kmwook03/CAN-Failsafe-Node/Reports/M3/CAN-Queue-Integration.md

# M3-2 CAN RX 큐 이관 기록

작업일: 2026-11-09 (Asia/Seoul)

차량 F446RE의 CAN 수신 처리를 ISR → CMSIS 메시지 큐 → `canRxTask`로 이관했다. Node 1은 기존 M2 Normal 펌웨어를 사용한다. **M3-2 정상 통신·RTOS 통합 시험은 사용자 보고 기준 PASS다.** 양 노드 3,000프레임 왕복과 CAN 시험 후 RTOS 진단을 확인했다.

## 사용자 보드 시험 결과

2026-11-09에 전달받은 [차량·조종기 원문 로그](evidence/can-queue/user-reported-uart.txt)를 보존했다.

| 항목 | 결과 | 판정 |
|---|---|---|
| 차량 정상 수신 / 송신 등록 / 송신 완료 | 각각 3,000회 | PASS |
| ISR 수신 / 큐 삽입 / 태스크 처리 | 각각 3,000회 | PASS |
| 큐 손실 / 읽기 오류 / 큐 API 오류 | 모두 0 | 정상 |
| CAN·데이터 오류 / Bus-Off / 타임아웃 / 시작·종료 오류 | 모두 0 | 정상 |
| 큐 최대 점유량 | 1 / 16 슬롯 | 해당 시험에서 적체 관측 없음 |
| ISR 수신부터 태스크 처리까지 관측 최대 대기 | 1ms (HAL tick 기준) | 기록값, 정밀 측정 및 상한 보장 아님 |
| CAN 태스크 최소 스택 여유 | 752 / 1,024 B = 73.4375% | 30% 기준 충족 |
| 조종기 최종 송신 / 에코 검증 | 각각 3,000회, 모든 오류 0 | PASS |
| LED 태스크 최소 스택 여유 | 832 / 1,024 B = 81.25% | 30% 기준 충족 |
| Monitor 태스크 최소 스택 여유 | 808 / 2,048 B = 39.453125% | 30% 기준 충족 |
| RTOS 최소 힙 여유 | 10,184 B | 여유 있음 |
| 시간 기준 / RTOS 오류 | `dt=1000/1000`, `tickErr=0 late=0/0 uartErr=0` | 정상 |
| 진단 / LED 전환 횟수 | `n=66 led=133` | 1초 진단과 0.5초 전환 주기에 부합 |

이번 Node 1 PASS는 RTOS 차량과의 시험에서 얻은 결과다. 2026-11-07의 양 노드 베어메탈 M2 시험 로그로 소급하지 않는다. CAN 처리와 결과 출력 후 다음 RTOS 진단을 추가로 받아 세 태스크의 스택 여유와 오류 카운터를 확인했다.

```text
[M3] n=66 led=133 dt=1000/1000 stackB=832/808 heapMinB=10184 tickErr=0 late=0/0 uartErr=0 canStackB=752
```

Monitor의 최소 스택 여유는 M3-1의 1,192 B에서 808 B로 줄었지만 30% 기준을 충족한다. 이후 기능을 추가할 때 다시 측정한다. 정상 CAN 왕복, 큐 무손실, RTOS 오류 0, 세 태스크 스택 여유 기준을 모두 충족하여 M3-2를 통과로 판정한다.

## 구현

- RX ISR은 한 번에 최대 3프레임을 꺼내 도착 시각과 함께 16슬롯 큐로 복사한다. `osMessageQueuePut()`의 timeout은 0이며, 실패 횟수를 별도 기록한다.
- AboveNormal 우선순위의 CAN 태스크가 검증·에코 송신·타임아웃·종료 판정을 담당한다. 큐 대기는 최대 10tick이며 프레임 도착 시 즉시 대기에서 풀린다.
- 큐는 커널 초기화 후 생성하고 CAN은 태스크에서 시작한다. 인터럽트가 아직 없는 큐를 사용하는 순서 문제를 피한다.
- M2와 동일한 ID/DLC/순번/페이로드를 사용한다. 길이가 정상인 손상 페이로드도 원문 그대로 에코한다.
- 수신/큐 삽입/처리/정상 검증/송신 등록/송신 완료가 모두 3,000회이고 오류와 잔여 큐 항목이 없어야 CAN PASS다.
- 첫 수신 전에는 계속 기다린다. 첫 수신 후 무수신 1초 이상, 전체 65초 이상, 큐 내 체류 1초 이상이면 실패로 종료한다. 마지막 수신 뒤 100ms를 기다려 송신 완료를 확인한다.
- 종료 시 CAN 알림과 세 IRQ를 끄고 결과를 고정한다. CAN 태스크는 suspend 상태로 남겨 스택을 확인하며 LED/진단 태스크는 계속 실행된다.
- UART 출력은 monitorTask만 수행한다. CAN 큐 최대 점유량, 최대 대기 시간, CAN 태스크 스택 여유를 추가했다.

## 보존과 검증

- M3-1 소스와 기록은 변경 전에 `C:\Users\kmwook\Desktop\docs\M3-1-baseline-2026-11-09.zip`으로 보존했다. SHA-256: `6f09b460fa049e3c2c164943e8a54a67dc45256004e4fd1bd273f0e82f6bba1d`.
- M3-1의 10분 PASS 기록과 이전 빌드 증빙은 그대로 유지했다. M3-2 증빙은 `evidence/can-queue/`에 분리한다.
- CubeMX로 재생성하여 새 태스크/우선순위/스택과 큐 생성·진입점 USER CODE 보존을 확인했다.
- Debug/Release 모두 오류 0건·경고 0건으로 빌드했다. 최종 ELF의 SVC/PendSV/SysTick/TIM6 및 CAN TX/RX0/SCE 벡터 연결, 실제 CAN 콜백과 큐 함수의 링크를 확인했다. 결과와 바이너리 해시는 `evidence/can-queue/build-summary.json`에, 컴파일 로그와 소스 해시는 같은 폴더에 기록했다.
- 실물 CAN 정상 통신, CAN 처리 후 세 태스크의 최소 스택 여유와 RTOS 오류 값은 사용자 전달 로그로 확인했다. 에이전트가 보드를 직접 조작하거나 UART를 수집한 결과는 아니다. queue overflow/Bus-Off 오류 주입은 미검증이다.

| 구성 | text | data | bss | 결과 |
|---|---:|---:|---:|---|
| Debug | 38,872 B | 104 B | 21,208 B | 오류 0 / 경고 0 |
| Release | 22,832 B | 104 B | 21,200 B | 오류 0 / 경고 0 |

ELF 크기와 컴파일러의 함수별 스택 보고서는 실행 중 최대 스택 사용량을 보장하지 않는다. 위 스택 판정은 CAN 결과 출력 이후 사용자가 전달한 실제 `stackB`/`canStackB` 값을 근거로 한다.

## 후속 작업

다음 단계는 Node 1을 RTOS로 이관해 20ms 주기 송신과 수신 큐를 구성하고 양 노드 RTOS 상태에서 왕복 시험을 반복하는 것이다. 실행 순서와 M3-2 합격 기준은 [M3_CAN_TEST.md](../../Firmware/Node2_Vehicle_F446RE/M3_CAN_TEST.md)에 있다. 나머지 주변장치 태스크 통합, 오류 주입, 전체 M3 24시간 시험은 별도로 남아 있다.
