kmwook03/CAN-Failsafe-Node/Reports/M3/Controller-RTOS-Migration.md

# M3-3 조종기 RTOS 이관 기록

작업일: 2026-11-09 (Asia/Seoul)

Node 1 L432KC의 20ms CAN 송신과 에코 검증을 FreeRTOS로 이관했다. 차량 Node 2는 M3-2에서 검증한 구성을 사용한다. **M3-3 정상 통신·RTOS 통합 시험은 사용자 보고 기준 PASS다.** 이번에 전달받은 양 노드 로그로 3,000회 왕복과 CAN 결과 출력 이후의 스택 여유·RTOS 상태를 확인했다.

## 사용자 보드 시험 결과

2026-11-09에 전달받은 [UART 원문 로그](evidence/controller-rtos/user-reported-uart.txt)를 보존했다. 에이전트가 직접 보드를 조작하거나 UART를 수집한 결과는 아니며, 보드에 기록된 바이너리 해시는 독립적으로 읽어 확인하지 않았다.

| 항목 | 조종기 Node 1 | 차량 Node 2 | 판정 |
|---|---|---|---|
| 송신 등록 / 실제 완료 / 정상 수신 | 각각 3,000 | 각각 3,000 | PASS |
| ISR 수신 / 큐 삽입 / 태스크 처리 | 각각 3,000 | 각각 3,000 | PASS |
| 큐 손실 / 읽기 오류 / 큐 API 오류 | 모두 0 | 모두 0 | 정상 |
| 데이터·CAN 오류 / Bus-Off / 타임아웃 / 시작·종료 오류 | 모두 0 | 모두 0 | 정상 |
| 큐 최대 점유량 | 1 / 16 | 1 / 16 | 해당 시험에서 적체 관측 없음 |
| 큐 최대 대기 시간 | 0ms | 1ms | HAL tick 기준 관측값 |
| 송신 설정 주기 / 최대 지각 / 슬롯 누락 / 대기 API 오류 | 20ms / 0tick / 0 / 0 | 해당 없음 | 정상 |
| RTOS / HAL 시간 증가량 | 1000 / 1000 | 1000 / 1000 | 정상 |
| tickErr / late / uartErr | 0 / 0·0 / 0 | 0 / 0·0 / 0 | 정상 |
| 최소 힙 여유 | 9,048 B | 10,184 B | 여유 있음 |
| 진단 / LED 전환 횟수 | n=64 / led=129 | n=65 / led=131 | 1초 진단·0.5초 LED 전환 주기에 부합 |

| 보드 / 태스크 | 최소 스택 여유 | 할당량 | 여유 비율 |
|---|---:|---:|---:|
| 조종기 LED | 832 B | 1,024 B | 81.25% |
| 조종기 Monitor | 784 B | 2,048 B | 38.28% |
| 조종기 CAN TX | 808 B | 1,024 B | 78.91% |
| 조종기 CAN RX | 800 B | 1,024 B | 78.13% |
| 차량 LED | 832 B | 1,024 B | 81.25% |
| 차량 Monitor | 808 B | 2,048 B | 39.45% |
| 차량 CAN RX | 752 B | 1,024 B | 73.44% |

모든 태스크가 최소 스택 여유 30% 기준을 충족한다. 조종기 Monitor의 여유가 가장 작으므로 이후 기능 통합 시 다시 측정한다. `maxWaitMs=0`은 동일 HAL tick 안에 처리됐다는 뜻이며 지연 시간이 물리적으로 0이라는 뜻은 아니다. `maxLateTicks=0`도 1ms 해상도에서 관측한 태스크 실행 지각 값으로, CAN 버스 전송 간격의 정밀 측정이나 최악 지연 상한 보장은 아니다.

이번 결과는 약 1분간 3,000회 CAN 왕복과 시험 종료 후 RTOS 상태를 확인한 것이다. 조이스틱·버튼·LCD 통합, 오류 주입, 전체 M3 24시간 시험은 별도로 남아 있다.

## 구현 범위

| 태스크 | CMSIS 우선순위 | 스택 | 역할 |
|---|---:|---:|---|
| canTxTask | AboveNormal1 (33) | 1,024 B | CAN 시작/송신/정지, 20ms 주기, 종료 판정 |
| canRxTask | AboveNormal (32) | 1,024 B | ISR 큐에서 에코 수신, 순번·페이로드 검증 |
| ledTask | Normal (24) | 1,024 B | 녹색 LED 500ms 토글 |
| monitorTask | Low (8) | 2,048 B | UART 단일 출력, 시간·스택·힙·오류 진단 |

- STM32CubeL4 V1.18.2에 포함된 FreeRTOS V10.3.1 / CMSIS-RTOS2 / ARM_CM4F / heap_4를 사용한다. 힙은 15,360 B, RTOS SysTick은 1kHz다.
- HAL 1ms 시간 기준은 TIM6로 분리했다. PCLK1과 타이머 클록은 48MHz, PSC=47, ARR=999다. M2에서 사용한 LSE 기준 MSI 자동 보정을 스케줄러 시작 전 적용한다.
- CAN은 Normal 500kbps, Prescaler=6, BS1=13, BS2=2, SJW=2다. CubeMX의 `CAN1.NART=ENABLE`로 자동 재전송 설정을 보존한다.
- CAN TX/RX0/SCE IRQ 우선순위는 5, SysTick/PendSV와 TIM6는 15다. 커널 호출 가능 IRQ 경계도 5다.
- 커널 초기화 후 16슬롯 수신 큐를 생성하고 모든 태스크 생성 성공을 확인한다. CAN은 TX 태스크에서 시작한다. RX 태스크는 준비 플래그를 기다린 뒤 큐에서 대기한다.
- RX ISR은 한 번에 최대 3프레임을 읽고 헤더·도착 시각·8바이트 데이터를 큐에 복사한다. ISR 큐 삽입 timeout은 0이다. ISR 안에서 UART나 프로토콜 검증을 수행하지 않는다.
- 조종기는 ID `0x100`으로 순번 0…2999와 `55 AA 12 34` 꼬리를 보내고, ID `0x200`의 동일 데이터를 검증한다. 전송 등록과 실제 TX mailbox 완료를 별도 집계한다.
- 시작 후 2초 대기, 20tick 절대 주기, 마지막 송신 뒤 1초 대기다. 20tick 이상 늦으면 `slips`를 누적하고 다음 기준 시각을 재설정해 밀린 송신을 연속 실행하지 않는다. uint32 tick 래핑을 고려하며 실행 제한은 첫 송신 예정 시각부터 65초다.
- Bus-Off, 큐 손실/오류, 읽기 오류, 송신 등록 실패는 조기 종료 조건이다. 오래된 큐 항목은 타임아웃으로 처리한다. 수신 부족과 데이터 오류도 최종 PASS를 막는다.
- 종료할 때 CAN 알림/IRQ를 끄고 CAN을 정지하며 RX 태스크를 suspend한 뒤 결과를 고정한다. TX도 suspend 상태로 남겨 두 태스크의 스택 여유를 계속 읽는다.
- CAN PASS에는 수신/큐 삽입/처리/정상 검증/송신 시도/등록/완료 각각 3,000회, 빈 큐, 오류·주기 누락 0이 모두 필요하다. RTOS 오류와 스택 기준은 CAN PASS와 별도로 확인한다.
- 스택 overflow·malloc 실패·assert는 `m3.fatal_reason`을 남기고 정지한다. UART는 monitorTask만 사용한다.

이번 단계에서는 M1의 조이스틱/버튼/LCD 애플리케이션을 실행하지 않는다. 해당 기능의 태스크 통합은 후속 단계다. 기존 M2 모듈은 `M2_TEST_ENABLED=0`으로 보존하며 동시에 활성화하면 컴파일 오류가 발생한다.

## 보존과 검증

- 수정 전 M3-2 전체 소스/기록을 `C:\Users\kmwook\Desktop\docs\M3-2-baseline-2026-11-09.zip`으로 보존했다.
- ZIP SHA-256: `c1dabe434612ba76a19f57a8c294c1c9deb2ca2155343b7aaef9675372341b5a`.
- M2/M3-1/M3-2 시험 증빙은 유지하고 이번 빌드 증빙은 `evidence/controller-rtos/`에 분리한다.
- Debug/Release 초기 빌드와 CubeMX 재생성 이후 최종 빌드 모두 오류 0건·컴파일 경고 0건으로 완료했다. 최종 빌드와 정적 연결 검사 결과는 같은 폴더의 `build-summary.json`에 기록했다. 빌드/링크 검사는 보드 실행을 대신하지 않는다.
- ELF의 SVC/PendSV/SysTick/TIM6와 CAN TX/RX0/SCE 벡터, 실제 CAN 콜백, 큐·태스크 플래그 함수, overflow/malloc hook의 강한 심볼 연결을 확인했다. M2 시험 함수는 최종 바이너리에 연결되지 않았다.
- CubeMX 재생성 뒤 태스크 진입점·큐 생성·LSE 보정·assert/hook의 USER CODE와 Debug/Release FreeRTOS 빌드 경로를 확인했다. CubeMX 6.18.1은 기존 ADC/DMA·가상 핀 메타데이터 관련 메시지와 IocParser 예외를 출력했으나 생성/저장은 최종 OK로 끝났다. 로그를 보존했고 생성된 코드 및 재빌드를 별도로 검증했다. 저장 파일의 IP 개수는 실제 10개 항목과 일치하도록 정리했다.
- 차량 측 소스·설정·문서 155개는 수정 전 SHA-256과 모두 일치한다. Debug/Release 산출물과 IDE 개인 설정은 이 비교 대상에서 제외했다.
- 실행 중 스택 여유, 송신 태스크 지각 관측치와 양 노드 3,000회 왕복은 위 사용자 로그로 확인했다. 오류 주입과 장시간 시험은 미검증이다. `build-summary.json`의 hardware pending 표기는 보드 로그 수신 전 빌드 당시 상태이며, 기존 빌드 증빙은 그대로 보존한다.

| 구성 | text | data | bss | 결과 |
|---|---:|---:|---:|---|
| Debug | 44,316 B | 100 B | 21,380 B | 오류 0 / 경고 0 |
| Release | 26,632 B | 100 B | 21,372 B | 오류 0 / 경고 0 |

최종 ELF SHA-256:

- Debug: `65d43372e968556f0f90988506767b1cb0f7122f1d9d836a9e0dfb99370fac36`
- Release: `2505990bfbec3ac1787c723a2f2f1b688e113c782ee9c9407e007cb2cf248d71`

실행 순서와 제출할 로그는 [Node 1 M3_TEST.md](../../Firmware/Node1_Controller_L432KC/M3_TEST.md)에 있다. 차량을 먼저 리셋하고 READY를 확인한 다음 조종기를 리셋한다.
