kmwook03/CAN-Failsafe-Node/Reports/M3/evidence/user-reported-uart.txt

M3-1 사용자 전달 기록
기록일: 2026-11-09 (Asia/Seoul)
출처: 사용자가 이 채팅에 전달한 UART 값과 LED 관찰.
UART에서 직접 저장한 원본 파일은 아니다. COM 포트, 빌드 구성,
실제 다운로드한 바이너리 해시는 전달되지 않았다.

[1] 사용자 원문
dt=1000/1000 stackB=832/1192 heapMinB=12048 tickErr=0 late=0/0 uartErr=0, LED는 빨강초록 점멸 중

[2] 최초 표본의 판정 범위 (후속 확인 전)
- 전달 표본에서 RTOS/HAL 증가량은 1000/1000으로 일치한다.
- LED 태스크 스택 여유: 832/1024 bytes = 81.25%.
- 진단 태스크 스택 여유: 1192/2048 bytes = 58.203125%.
- 두 태스크 모두 이 표본에서는 계획의 여유 30% 기준을 충족한다.
- 관측된 RTOS 최소 힙 여유는 12048 bytes.
- tick 불일치, 주기 대기 실패, UART 오류 카운터는 모두 0.
- LED 점멸은 사용자 보고이나 LED의 보드 표기(LD2 등)와 0.5초 전환 간격은 미확인.
- n/led 카운터와 m3.fatal_reason 값은 전달되지 않았다.
- 10분 연속 시험, 리셋/HardFault 이력, 전체 M3 24시간 시험은 미확인.

[3] 10분 실행 후 사용자 원문 (2026-11-09)
10분 실행 결과 Err 값은 전부 0이고 LD2도 0.5초마다 점멸함. [M3] n=668 led=1337 dt=1000/1000 stackB=832/1192 heapMinB=12048 tickErr=0 late=0/0 uartErr=0.

[4] 후속 판정
- 사용자 보고를 근거로 M3-1의 10분 기본 동작 시험 PASS.
- n=668은 1초 진단 주기에서 약 668초(11분 8초)의 실행과 일치한다.
  정밀 시간 실측값은 아니다.
- led=1337은 시작 직후 1회 전환 + 668초 동안 초당 2회 전환과 일치한다.
- LD2의 0.5초 전환 간격을 사용자가 확인했다.
- tickErr=0, late=0/0, uartErr=0이며 스택·최소 힙 여유가 최초 표본과 같다.
- 에이전트가 보드를 직접 측정한 기록은 아니며 원본 연속 UART 파일은 없다.
- 전체 M3(양 노드 태스크 이관 및 24시간 시험)의 완료 판정은 아니다.
