kmwook03/CAN-Failsafe-Node/Docs/Plan.md

# 계획서

## 0. 개요

조이스틱 입력을 CAN 메시지로 변환해 전송하는 조종기 노드와, 이를 수신해 모터를 구동하되 자체 판단으로 명령을 거부할 수 있는 차량 노드로 구성된 2노드 분산 제어 시스템을 설계한다.  두 개의 노드로 분리하고 CAN을 도입한 이유는, 실제 차량 E/E 아키텍처의 최소 단위를 재현하기 위해서이다. 오늘날 차량에서 스티어링 조작은 배선으로 바퀴에 전달되지 않는다. 메시지로 변환되어 네트워크를 타고 흐르고, 수신측 ECU가 이를 해석해 액추에이터를 움직인다. 이 구조에서는 "명령이 도착하지 않았을 때 어떻게 행동할 것인가"가 기능 구현만큼 중요해진다.이 프로젝트의 목표는 동작하는 RC카를 만드는 것이 아니라, 그 질문에 대한 답을 설계로 구현하고 수치로 증명하는 것이다.

### 사용 보드

| 역할 | 보드 |
| --- | --- |
| Node 1: 조종기 | STM32 NUCLEO-L432KC |
| Node 2: 차량 | STM32 NUCLEO-F446RE |

## 1. 시스템 아키텍처

```
┌───────────────────────────────────┐        ┌───────────────────────────────────┐
│  Node 1 : REMOTE (CAN ID 0x100)   │        │  Node 2 : VEHICLE (CAN ID 0x200)  │
│  ── NUCLEO-L432KC (Cortex-M4F) ── │        │  ── NUCLEO-F446RE (Cortex-M4F) ── │
│                                   │        │                                   │
│  CLK : MSI 48MHz (LSE 트리밍)      │  CAN   │  CLK : HSE 8MHz Bypass → 160MHz   │
│  Joystick  ─ ADC1 + DMA           │◄──────►│  HC-SR04 ─ TIM Input Capture      │
│  Buttons×3 ─ EXTI                 │500kbps │  L298N   ─ TIM3 PWM 20kHz         │
│   LCD      ─ I2C1 + DMA           │ 120Ω×2 │  Motor L / R (Differential Drive) │
│  전원 : USB 보조배터리 (배터리 구동) │        │  전원 : 18650 ×2 + 보조배터리      │
└───────────────────────────────────┘        └───────────────────────────────────┘
```

이 시스템의 출발점은 조종기와 차량을 두 개의 독립 컴퓨터로 만든다는 결정이다. 각 MCU는 서로 다른 일을 하며 CAN 버스를 통해 메시지로 통신한다. 노드 1은 사람의 의도를 읽어 메시지로 만들고 노드 2는 메시지를 물리적인 힘으로 구현한다.

Node 1은 계산량이 거의 없기 때문에 NUCLEO-L432KC 보드를 사용하기로 하였고, Node 2는 초음파 센서 반사파 도달 시간 실시간 측정, 두 모터의 PWM을 20kHz로 제어, 동시에 CAN 수신과 안전 상태 판정 체크 등 실시간 부담이 크기 때문에 NUCLEO-F446RE 보드를 사용하기로 하였다.

CAN에는 별도의 클럭 선이 없기 때문에 송신측과 수신측이 각자의 클럭으로 비트 경계를 판단하고 데이터 자체의 엣지를 보며 조금씩 서로 보정해야 한다.

### 1-1. **태스크 설계 - Node 1 (조종기 / L432KC @ 48 MHz)**

| 태스크 | 우선순위 | 주기 | 스택(word) | 역할 | 블로킹 |
| --- | --- | --- | --- | --- | --- |
| `CanTxTask` | 4 | 20ms | 256 | 제어 프레임 송신, Counter/CRC 부착 | osDelayUntil |
| `InputTask` | 3 | 10ms | 256 | ADC 이동평균, 데드존, 버튼 디바운스 | osDelayUntil |
| `CanRxTask` | 3 | 이벤트 | 256 | 차량 텔레메트리 수신 → 상태 저장 | Queue Wait |
| `UiTask` | 1 | 100ms | 512 | 1602 I2C LCD 프레임버퍼 렌더 + I2C DMA 전송 | DMA Semaphore |

### 1-2. **태스크 설계 - Node 2 (차량 / F446RE @ 160 MHz)**

| 태스크 | 우선순위 | 주기 | 스택(word) | 역할 | 블로킹 |
| --- | --- | --- | --- | --- | --- |
| `SafetyTask` | 5 | 20ms | 256 | 센서/링크 상태 종합 → 시스템 상태 결정 | osDelayUntil |
| `SensorTask` | 4 | 50ms | 256 | HC-SR04 트리거 
+ Input Capture 결과 수신 | Semaphore
(타임아웃 30ms) |
| `CanRxTask` | 4 | 이벤트 | 256 | 명령 파싱, CRC 검증, 최종 수신시각 갱신 | Queue Wait |
| `MotorTask` | 3 | 20ms | 256 | PWM 유일 소유자.
상태에 따라 출력 결정 + IWDG 갱신 | osDelayUntil |
| `TelementryTask` | 1 | 100ms | 256 | 차량 상태를 조종기로 회신 | osDelayUntil |

RMS(Rate Monotonic)를 기본으로 하되, 안전 관련 태스크는 주기와 무관하게 상위 배치 하였다.

총 CPU 이용률 U = ∑(Ci/Ti)를 실측하여 Liu & Layland 한계(n = 5 → 약 74%) 이내임을 증명할 것이다.

## 2. **Fail-safe 설계**

### 2-1. **단일 소유권(Single Ownership) + 상태 머신**

```
[SensorTask]  ─┐
[CanRxTask]   ─┼─► (Shared State + Mutex) ─► [SafetyTask] ─► g_system_state
[Button/EXTI] ─┘                                                    │
                                                                    ▼
                                                  [MotorTask] ──► PWM (유일한 쓰기 주체)
```

다른 태스크들은 모터를 건드리는 대신, SafetyTask에 데이터를 전송한다. 즉, 판단은 하지 않고 관측만 하는 것이다. 판단은 SafetyTask에서 받은 데이터들을 취합하여 시스템이 어떤 상태여야하는지 결정한다. MotorTask는 20ms마다 깨어나 상태를 읽고, 그 상태에 적합한 출력을 PWM에 쓴다. 이를 통해 SensorTask와 MotorTask의 경쟁 상태가 발생할 수 없도록 한다.

시스템의 상태는 아래와 같이 설계하였다.

| 상태 | 진입 조건 | 모터 출력 | 탈출 조건 |
| --- | --- | --- | --- |
| `INIT` | 부팅 | 정지 | 자가진단 통과 |
| `SAFE_STOP` | 시동 전 / 리셋 후 | 정지 | 조이스틱 중립 버튼
 + Arm 버튼 |
| `RUN` | 정상 | CAN 명령대로 | 아래 조건 발생 시 전이 |
| `EMERGENCY_BRAKE` | 전방 < 15cm AND 전진 명령 | 강제 정지 (후진 허용) | 거리 > 25cm 
(히스테리시스) |
| `LINK_LOST` | 마지막 유효 CAN 수신 후 > 150ms | 정지 | 유효 프레임 3연속 수신 |
| `FAULT` | 센서 무응답 / Bus-Off /
CRC 연속 오류 | 정지 (Latched) | 수동 리셋 |

충돌 위험 감지 거리와 해제 거리가 서로 다른 이유는, 같은 거리(15cm)로 평가를 하게 되면 차량이 15cm 경계에 있을 때 센서 노이즈가 14.9와 15.1 사이로 튀며 모터가 돌았다 멈췄다를 반복하기 때문이다.

### 2-2. **Link Loss Detection**

이 시스템은 네트워크를 사용해 통신한다. 네트워크가 가져오는 위험은 다음과 같다.

1. 메시지가 안옴
    
    조종기가 죽었거나 케이블이 빠진 경우다. 이 때 차량이 이전 명령을 유지하면 마지막 명령이 전진이었을 경우 차는 계속 달린다. 따라서 150ms 타임아웃을 설정하여 정지시킬 것이다.
    
2. 메시지가 오는데 내용이 안바뀜
    
    송신 태스크가 행에 걸렸는데 하드웨어 버퍼가 같은 프레임을 계속 재전송하는 경우다. 이 때는 타임아웃이 아닌 롤링 카운터로 판별해야 한다.
    
3. 메시지가 깨짐
    
    모터 노이즈나 비트 오류로 데이터가 변형된 경우다. 스로틀 0이 100으로 바뀌면 치명적일 수 있다. CRC-8로 검증하고 틀리다면 그 프레임을 버리는 방식으로 방어할 것이다.
    
4. 물리계층이 망가짐
    
    CAN 컨트롤러는 오류가 누적되면 스스로 버스에서 이탈한다(Bus-Off). 이를 감지해 카운터에 기록해두고 재초기화를 시도하는 로직을 추가한다. 핵심은 침묵이 아닌 기록 남기기다.
    
5. 소프트웨어가 멈춤
    
    태스크가 데드락에 빠지면 모든 로직이 무력화된다. 이를 방지하기 위해 독립 워치독이 100ms마다 갱신을 요구하고 갱신되지 않으면 MCU를 강제로 리셋한다. 갱신 책임은 MotorTask가 갖는다. 실제로 액추에이터를 제어하는 태스크가 살아있는지 확인하고싶은 것이기 때문이다.

리셋되면 부팅 후 SAFE_STOP으로 들어간다. 이 때 모터는 정지상태이므로, 결과적으로 모든 실패 경로가 정지로 수렴하도록 설계하였다.

| 기법 | 구현 | 검출 대상 |
| --- | --- | --- |
| **Timeout (E2E)** | 20ms 주기 송신 → 150ms 미수신 시 LINK_LOST | 케이블 단선, 조종기 전원 차단 |
| **Rolling Counter** | 0~15 순환, 값이 정지하면 Freeze 판정 | 송신 태스크 행(Hang), 버퍼 재전송 |
| **CRC-8 (SAE J1850)** | Payload 7바이트 → CRC 1바이트 | 비트 오류, 타 노드 오염 |
| **Bus-Off 복구** | HAL_CAN_ERROR_BOF 감지
 → 카운트 기록 후 재초기화 | 물리 계층 이상 |
| **IWDG** | 100ms 타임아웃, MotorTask에서만 갱신 | 태스크 데드락 |

## 3. **클럭 및 CAN 설계**

### 3-1. **조종기(L432KC) 클럭**

CAN은 정확한 클럭을 요구한다. 그러나 NUCLEO-L432KC에는 HSE 크리스털이 실장되어 있지 않다. 고려해볼 수 있는 선택지는 아래와 같았다.

| 방안 | 정확도 | 문제점 | 판정 |
| --- | --- | --- | --- |
| **A. HSI16 그대로** | ±1% 이상 | CAN 허용 오차 초과. 처음엔 되는 듯하다가 **간헐적으로 Error Frame 폭주** | ❌ 불가 |
| **B. SB17 납땜 → ST-LINK MCO 8MHz를 HSE로** | 양호 | **USB를 뽑으면 ST-LINK가 꺼져서 클럭이 사라짐.** 조종기를 배터리로 못 씀. SMD 납땜 필요 | ⚠️ 차선 |
| **C. MSI 48MHz + LSE 32.768kHz 자동 트리밍** | **±0.25% 이내** | LSE 사용 시 D7/D8(PC14/PC15) 사용 불가 (어차피 안 씀) | ✅ **채택** |

STM32L4의 MSI는 LSE 크리스털에 의해 하드웨어적으로 자동 보정(MSI PLL Mode)되며, 이때 정확도가 ±0.25% 이내로 들어온다. NUCLEO-L432KC에는 32.768kHz LSE 크리스털이 기본 실장되어 있으므로 추가 부품 없이 가능하다.

### 3-2. **차량(F446RE) 클럭**

F446RE는 Nucleo-64라 ST-LINK MCO 8MHz가 기본 연결되어 있다(HSE Bypass).

- HSE 8 MHz Bypass → PLL → SYSCLK 160 MHz
- APB1 Prescaler = /4 → PCLK1 = 40 MHz (F446 APB1 최대 45MHz 이내)

PCLK1을 40MHz로 맞추면 아래처럼 두 노드의 tq 개수와 샘플포인트가 완전히 동일해진다. 서로 다른 MCU 간 CAN에서 타이밍 불일치는 가장 흔한 실패 원인이므로, 클럭을 조금 낮추더라도 맞추는 쪽이 이득일 것으로 예상했다.

### 3-3. **CAN 비트 타이밍 (500kbps, 양 노드 동일)**

| 항목 | Node 1 (L432KC) | Node 2 (F446RE) |
| --- | --- | --- |
| 클럭 소스 | MSI 48MHz (LSE 트리밍) | HSE 8MHz Bypass → PLL |
| SYSCLK | 48 MHz | 160 MHz |
| **PCLK1 (CAN 클럭)** | **48 MHz** | **40 MHz** |
| **Prescaler** | **6** | **5** |
| tq 클럭 | 8 MHz | 8 MHz |
| SYNC_SEG | 1 tq | 1 tq |
| **BS1 (TSEG1)** | **13 tq** | **13 tq** |
| **BS2 (TSEG2)** | **2 tq** | **2 tq** |
| **총 tq** | **16** | **16** |
| **Bitrate** | **500 kbps**  | **500 kbps**  |
| **Sample Point** | **87.5%** | **87.5%** |
| **SJW** | **2 tq** | **2 tq** |
- 검산
    - 48 MHz ÷ 6 = 8 MHz, 8 MHz ÷ 16 tq = 500 kHz
    - 40 MHz ÷ 5 = 8 MHz, 8 MHz ÷ 16 tq = 500 kHz

CAN 오실레이터 허용오차는 대략 df ≤ SJW / (20 × NBT_tq) 이다. SJW=1이면 1/(20×16) = 0.3125% 로, MSI의 ±0.25%와 여유가 거의 없다. SJW=2로 올리면 0.625%가 되어 안전 마진이 2배가 되므로 SJW를 2로 설정하였다. 

### 3-4. **CAN 메시지 정의**

**`0x100` — REMOTE_CMD (조종기 → 차량, 20 ms 주기)**

| Byte | 필드 | 타입 | 범위 | 설명 |
| --- | --- | --- | --- | --- |
| 0 | `throttle` | int8 | -100 ~ +100 | 전후진 (%) |
| 1 | `steering` | int8 | -100 ~ +100 | 좌우 조향 (%) |
| 2 | `mode` | uint8 | 0~2 | 0=SAFE, 1=NORMAL, 2=SPORT |
| 3 | `flags` | bitfield | - | bit0=E-Stop, bit1=Arm, bit2=Reserved |
| 4~5 | `reserved` | - | - | 확장용 (0 채움) |
| 6 | `counter` | uint8 | 0~15 | Rolling Counter (하위 4bit) |
| 7 | `crc8` | uint8 | - | Byte0~6에 대한 CRC-8 |

**`0x200` — VEHICLE_STATUS (차량 → 조종기, 100 ms 주기)**

| Byte | 필드 | 설명 |
| --- | --- | --- |
| 0 | `state` | 시스템 상태 (RUN / E_BRAKE / LINK_LOST / FAULT) |
| 1 | `distance_cm` | 전방 거리 (255 = 측정 불가) |
| 2 | `pwm_left` | 좌측 모터 실제 듀티 (%) |
| 3 | `pwm_right` | 우측 모터 실제 듀티 (%) |
| 4 | `err_count` | 누적 CRC/타임아웃 오류 수 |
| 5 | `cpu_load` | CPU 사용률 (%) — 실측 증빙용 |
| 6 | `counter` | Rolling Counter |
| 7 | `crc8` | CRC-8 |

CAN은 ID가 낮을수록 우선순위가 높다. 제어 명령(0x100)에 상태보고(0x200)보다 낮은 ID를 할당한 것은 버스 경합 시 제어 프레임이 먼저 나가야 하기 때문이다.

### 3-5. 버스 부하 계산

표준 프레임 8바이트 ≈ 111 bit + 스터핑 여유 ≈ 130 bit

| 메시지 | 주기 | 초당 프레임 | 초당 비트 | 부하 |
| --- | --- | --- | --- | --- |
| 0x100 | 20 ms | 50 | 6,500 | 1.3 % |
| 0x200 | 100 ms | 10 | 1,300 | 0.26 % |
| 합계 |  |  |  | 약 1.6 % |

---

## 4. 핀 할당

### 4.1 Node 1 — NUCLEO-L432KC (조종기)

> 32핀 패키지라 여유가 적으므로 **아래 표대로 고정**하는 것을 권장합니다.
> 

| 기능 | STM32 핀 | 보드 라벨 | 주변장치 | 비고 |
| --- | --- | --- | --- | --- |
| **CAN1_RX** | **PA11** | **D10** | CAN1 (AF9) | L432KC에서 CAN은 이 조합뿐 |
| **CAN1_TX** | **PA12** | **D2** | CAN1 (AF9) |  |
| Joystick VRx | PA0 | A0 | **ADC1_IN5** | ⚠️ F4의 IN0 아님 |
| Joystick VRy | PA1 | A1 | **ADC1_IN6** | DMA Circular |
| Joystick SW | PA3 | A2 | GPIO Input (Pull-up) |  |
| 1602 I2C LCD SCL | PB6 | D5 | I2C1_SCL | **100 kHz Fast Mode** |
| 1602 I2C LCD SDA | PB7 | D4 | I2C1_SDA | DMA 전송 |
| Button 1 (Arm) | PB0 | D3 | EXTI, Pull-up |  |
| Button 2 (Mode) | PB1 | D6 | EXTI, Pull-up |  |
| Button 3 (E-Stop) | PA8 | D9 | EXTI, Pull-up |  |
| Status LED | PB3 | D13 | 온보드 LD3 (녹색) |  |
| Debug UART TX | PA2 | (A7) | USART2 → VCP | ⚠️ **A7은 다른 용도로 못 씀** |
| Debug UART RX | PA15 | (내부) | USART2 → VCP | 커넥터에 안 나옴 |
| LSE 크리스털 | PC14 / PC15 | **D7 / D8** | OSC32_IN/OUT | 🔒 **GPIO로 사용 불가** |
| SWD | PA13 / PA14 | (내부) | ST-LINK 디버그 | 🔒 사용 불가 |

**남는 자유 핀:** PA4(A3), PA5(A4), PA6(A5), PA7(A6), PA9(D1), PA10(D0), PB4(D12), PB5(D11) → 확장 여유 충분

> ⚠️ **I2C 솔더 브리지 확인:** UM1956에 따르면 A4/A5와 D4/D5의 I2C 배선은 SB16/SB18 설정에 따라 달라진다. 기본 상태에서는 PB6=D5(SCL), PB7=D4(SDA)로 알려져 있으나, LCD가 안 잡히면 이 브리지를 가장 먼저 의심할 것.
> 

### 4.2 Node 2 — NUCLEO-F446RE (차량)

| 기능 | 핀 | 보드 라벨 | 주변장치 | 비고 |
| --- | --- | --- | --- | --- |
| CAN1_RX / TX | PA11 / PA12 | CN10 | CAN1 (AF9) |  |
| Motor L ENA (PWM) | PA6 | D12 | TIM3_CH1 | 20 kHz |
| Motor R ENB (PWM) | PA7 | D11 | TIM3_CH2 | 20 kHz |
| IN1 / IN2 | PB12 / PB13 | CN10 | GPIO Output | 좌측 방향 |
| IN3 / IN4 | PB14 / PB15 | CN10 | GPIO Output | 우측 방향 |
| HC-SR04 TRIG | PC7 | D9 | GPIO Output | 10 µs 펄스 |
| HC-SR04 ECHO | PB6 | D10 | **TIM4_CH1 Input Capture** | ⚠️ 분압 필요 |
| Status LED | PA5 | D13 | 온보드 LD2 |  |
| Debug UART | PA2 / PA3 | - | USART2 → VCP |  |

> **PWM 20 kHz를 쓰는 이유:** 가청 주파수(20Hz~20kHz) 위로 올려 모터 코일 소음("삐----")을 제거하기 위함. L298N은 스위칭이 느려 40kHz 이상은 무리이므로 20kHz가 적정선.
> 

## 5. 부품 명세

### 5-1. 핵심 제어 및 네트워크

| 부품명 | 수량 | 배치 노드 | 용도 및 비고 |
| --- | --- | --- | --- |
| STM32 NUCLEO-F446RE | 1개 | 차량 | 시스템의 메인 두뇌 (Node) |
| STM32 NUCLEO-L432KC | 1개 | 조종기 |  |
| SN65HVD230 CAN 모듈 | 2개 | 조종기(1), 차량(1) | 조종 명령 송신 및 수신 (3.3V 인가) |

### 5-2. 구동부 및 전원

| 부품명 | 수량 | 배치 노드 | 용도 및 비고 |
| --- | --- | --- | --- |
| 2WD 스마트카 섀시 키트 | 1세트 | 차량 | 차량 프레임, 바퀴 2개, DC 기어드 모터 2개 포함 |
| L298N 모터 드라이버 | 1개 | 차량 | NUCLEO의 PWM 신호를 받아 DC 모터에 큰 전력을 공급 |
| 18650 배터리 2구 홀더 & 건전지 | 1세트 | 차량 | **AA 건전지 4구/6구 홀더** 또는 **18650 배터리 2구 홀더** (L298N 메인 전원용) |
| USB 보조배터리 | 2 | 조종기(1), 차량(1) | PC에서 분리하여 사용하기 위함 |
| 0.1 µF 세라믹 커패시터 | 6 | 차량 | 모터 단자에 3개씩 납땜 |

### 5-3. 센서 및 인터페이스

| 부품명 | 수량 | 배치 노드 | 용도 및 비고 |
| --- | --- | --- | --- |
| KY-023 조이스틱 모듈 | 1개 | 조종기 | 전후좌우 조향 아날로그(ADC) 입력 |
| HC-SR04 초음파 센서 | 1개 | 차량 | 차량 전방에 부착, 장애물 거리 측정 
분압(1kΩ + 2kΩ)을 통해 3.3V로 출력을 낮출 것 |
| 1kΩ, 2kΩ 저항 | 각 1개 | 차량 | 초음파 센서 전압 분압용 |
| 1602 I2C LCD | 1개 | 조종기 | 현재 모터 출력, 연결 상태, 경고 메시지 표시 |
| 택트 스위치 (Push Button) | 3개 | 조종기 | 주행 모드 변경 또는 수동 긴급 정지 버튼 |

### 5-4. 배선 및 인프라

| 부품명 | 수량 | 배치 노드 | 용도 및 비고 |
| --- | --- | --- | --- |
| 브레드보드 (830핀 또는 400핀) | 2개 | 조종기(1), 차량(1) | 각 노드별 회로 구성 |
| 점퍼선 세트 (M-M, M-F, F-F) | 1세트 | 조종기(1), 차량(1) | 보드, 모듈, 센서 간 배선 
(암수 혼합 필수, 향후 납땜 예정) |
| Mini-B USB 케이블 | 1개 | 차량 | PC 연결, NUCLEO 펌웨어 다운로드 및 디버깅 |
| Micro-B USB 케이블 | 1개 | 조종기 | PC 연결, NUCLEO 펌웨어 다운로드 및 디버깅 |

### 5-5. 전원 계통도

```
[조종기 Node 1]
  USB 보조배터리 ──(Micro-B)── NUCLEO-L432KC ── 3V3 ─┬── SN65HVD230
                                                    ├── 조이스틱 (KY-023)
                                                    └── 1602 I2C LCD
  ※ MSI+LSE 클럭이므로 ST-LINK 없이도 정상 동작 (HSE였다면 불가)

[차량 Node 2]
  18650 ×2 (7.4V) ──── L298N VMS (모터 구동)
  USB 보조배터리 ──(Mini-B)── NUCLEO-F446RE ── 3V3 ── SN65HVD230
                                           └── 5V ── HC-SR04

★★★ L298N GND ↔ NUCLEO GND ↔ 조종기 GND(CAN 접지) 모두 연결 ★★★
     공통 접지 없으면 모터도 안 돌고 CAN도 안 된다.
```

## 6. 마일스톤 계획 (8주)

각 마일스톤은 완료 기준(DoD)을 만족해야 다음으로 진행.

### 🔹 M0 — 준비 (Week 1)

| 항목 | 내용 |
| --- | --- |
| **목표** | 부품 수령, 개발 환경, 저장소 세팅 |
| **작업** | ① 부품 발주(§5 반영, **케이블 2종 주의**) 
② STM32CubeIDE 설치 
③ **L432KC / F446RE 각각 별도 프로젝트** 생성 
④ Git 저장소 + 회로도 초안 |
| **DoD** | 두 보드 모두 LED 블링크 + `printf`가 UART VCP로 출력. 
**L432KC는 PB3(D13), F446RE는 PA5(D13)** |
| **리스크** | 부품 배송 지연 → 1주차에 즉시 발주 |

### 🔹 M1 — 드라이버 개별 검증 (Week 2)

| 항목 | 내용 |
| --- | --- |
| **목표** | **RTOS 없이 베어메탈로** 각 주변장치 개별 검증 |
| **작업** | **[L432KC]** 
① `HAL_ADCEx_Calibration_Start()` 후 ADC+DMA로 조이스틱 값 UART 출력 
② 1602 I2C LCD 드라이버 이식 
③ 버튼 EXTI + 디바운스 
**[F446RE]** 
④ TIM3 PWM 모터 단독 회전 
⑤ HC-SR04 **Input Capture 방식** 거리 측정 (`HAL_Delay` 폴링 금지) |
| **DoD** | 5개 주변장치가 **각각** 독립 프로젝트에서 동작. 거리 오차 ±2cm 이내 |
| **L432KC 함정** | ADC 캘리브레이션 누락 시 값이 튄다. 채널 번호가 IN5/IN6인 것도 확인할 것. |

### 🔹 M2 — 클럭 & CAN 링크 확립 (Week 3)

> **2026-11-07 검증 상태:** 양 노드 Loopback 정상 확인 및 연결 버스 60Ω 측정 완료(사용자 보고).
> Normal 시험에서 Node 2의 수신·응답 3,000회와 오류 0을 확인했다.
> Node 1 최종 PASS 로그 재확인, CAN 비트폭 2µs 및 MCO 주파수 실측은 남아 있어 M2 전체 완료 판정은 보류한다.
> [검증 결과·실패 이력·남은 항목](../Reports/M2/CAN-Link-Validation.md)

| 항목 | 내용 |
| --- | --- |
| **목표** | 두 노드 간 CAN 프레임 왕복 성공 |
| **작업** | ① [L432KC] LSE 활성화 + MSI 48MHz + MSIPLLEN 설정 후 MCO 핀으로 클럭 출력해 주파수 실측 
② [F446RE] HSE Bypass → 160MHz / APB1 40MHz 
③ 양 노드 **Loopback 모드**로 자체 송수신 검증 
④ CANH-CANL 저항 측정(60Ω 확인) 
⑤ Normal 모드 2노드 통신 
⑥ FIFO0 인터럽트 + Bus-Off 핸들러 |
| **DoD** | 1분간 3,000프레임 송수신 **오류 0건**. 로직 애널라이저로 비트폭 **2 µs (=500kbps)** 확인 |
| **리스크** | 🔴 **여기서 막히면 프로젝트가 멈춘다.** 
체크리스트: 
① LSE 발진 확인(`HAL_RCC_OscConfig` 리턴값) 
② MSIPLLEN 활성 여부 
③ CANH↔CANH / CANL↔CANL 직결(크로스 아님) 
④ 공통 접지 
⑤ 종단 60Ω 
⑥ 트랜시버 3.3V 
⑦ 양 노드 tq=16 일치 |
| **폴백** | 그래도 안 되면 SJW=3 / BS1=12 / BS2=3으로 마진 확대. 
그것도 안 되면 SB17 납땜 후 HSE 방식(방안 B)으로 전환 |

### 🔹 M3 — RTOS 통합 (Week 4)

| 항목 | 내용 |
| --- | --- |
| **목표** | §1의 태스크 구조로 마이그레이션 |
| **작업** | ① CMSIS-RTOS v2 활성화, **HAL Timebase를 TIM6/TIM7로 이관** 
② 태스크 생성 및 우선순위 부여 
③ Queue(CAN RX) / Mutex(공유 상태) / Semaphore(HC-SR04 완료) 
④ `uxTaskGetStackHighWaterMark`로 스택 리사이징 |
| **DoD** | 양 노드 동시 구동 24시간 무정지. 스택 여유 30% 이상. **HardFault 0건** |
| **함정** | RTOS에서 `HAL_Delay()` 금지 → `osDelay()`. ISR에서는 반드시 `...FromISR()` API |

### 🔹 M4 — 주행 통합 (Week 5)

| 항목 | 내용 |
| --- | --- |
| **목표** | 실제로 조종되는 차 |
| **작업** | ① 차동 구동 믹싱 (`L = throttle + steering`, `R = throttle - steering`, 클리핑) 
② 데드존 ±8% 
③ 슬루레이트 제한(급가속 시 전압강하 리셋 방지) 
④ 1602 I2C LCD 대시보드 레이아웃 |
| **DoD** | 조이스틱으로 전진/후진/제자리 회전. 1분 주행 시 리셋 0회 |
| **리스크** | 모터 노이즈 리셋 → 커패시터 추가, 전원 분리 재점검 |

### 🔹 M5 — Fail-safe 구현 (Week 6)

| 항목 | 내용 |
| --- | --- |
| **목표** | §2 상태머신 완성 |
| **작업** | ① 시스템 상태머신 
② 긴급제동(히스테리시스 15/25cm, 후진 허용) 
③ Link Timeout 150ms 
④ Rolling Counter + CRC-8 
⑤ Bus-Off 자동 복구 
⑥ IWDG 100ms 
⑦ 1602 I2C LCD/LED 경고 표시 |
| **DoD** | §7.2의 F1~F7 전부 통과 |
| **산출물** | 상태 전이 다이어그램, 테스트 결과표 |

### 🔹 M6 — 측정 및 튜닝 (Week 7)

| 항목 | 내용 |
| --- | --- |
| **목표** | "잘 된다"가 아니라 "몇 ms 걸린다"로 말하기 |
| **작업** | ① GPIO 토글 + 로직 애널라이저로 **E2E 응답시간** 측정 
② FreeRTOS Runtime Stats로 태스크별 CPU 점유율 
③ CAN 버스 부하율 실측 
④ 100회 반복 최악 응답시간(WCRT) 
⑤ 병목 시 주기/우선순위 튜닝 |
| **DoD** | 아래 표를 실측값으로 채움 |

| 측정 항목 | 목표 | 실측 |
| --- | --- | --- |
| 조이스틱 입력 → 모터 반응 (E2E) | < 50 ms | _____ |
| 장애물 감지 → 모터 정지 | < 70 ms | _____ |
| CAN 두절 → 정지 | < 200 ms | _____ |
| Node1 CPU 이용률 (48MHz) | < 60 % | _____ |
| Node2 CPU 이용률 (160MHz) | < 40 % | _____ |
| 정지 거리 (PWM 60% 주행 중) | < 20 cm | _____ |

> **L432KC 추가 측정 :** 48MHz 동작 시 소비 전류를 측정해 두면 "저전력 MCU를 선택한 이유"를 수치로 뒷받침할 수 있다.
> 

### 🔹 M7 — 문서화 및 데모 (Week 8)

| 항목 | 내용 |
| --- | --- |
| **목표** | 남에게 보여줄 수 있는 형태로 포장 |
| **작업** | ① README(아키텍처, 핀맵, 빌드법) 
② CAN 메시지 명세서 
③ **클럭 설계 결정 문서(§3.1)** 
④ 회로도 PDF 
⑤ **트러블슈팅 로그** 
⑥ 데모 영상 2분 
⑦ 로직 애널라이저 캡처 |
| **DoD** | 처음 보는 사람이 README만 읽고 프로젝트를 이해 |

### 6.1 일정 요약

| 주차 |
| --- |
|  |
| 난이도 |

| W1 | W2 | W3 | W4 |
| --- | --- | --- | --- |
| M0 준비 | M1 드라이버 | M2 클럭+CAN | M3 RTOS |
| ★ | ★★ | ★★★★★ | ★★★ |

| W5 | W6 | W7 | W8 |
| --- | --- | --- | --- |
| M4 주행 | **M5 Fail-safe** | M6 측정 | M7 문서화 |
| ★★★ | ★★★★ | ★★★ | ★★ |

> **버퍼 전략:** M2(클럭+CAN)와 M5(Fail-safe)가 가장 위험. 일정이 밀리면 M4의 SPORT 모드나 M7의 회로도 PDF를 먼저 잘라내고, M5·M6은 사수할 것. M5·M6이 없으면 그냥 "RC카 만들었어요"가 됨.
> 

## 7. 검증 계획

### 7.1 정상 동작 테스트

| # | 항목 | 방법 | 합격 기준 |
| --- | --- | --- | --- |
| N1 | 조향 선형성 | 조이스틱 25/50/75/100% | PWM 듀티 비례 증가 |
| N2 | 데드존 | 조이스틱 중립 방치 | 모터 완전 정지, 떨림 없음 |
| N3 | 장시간 안정성 | 30분 연속 주행 | 리셋/행 0회 |
| N4 | 텔레메트리 | 1602 I2C LCD 표시값 vs 실제값 | 거리 오차 ±2cm |
| **N5** | **클럭 안정성** | **조종기를 USB에서 분리 → 보조배터리 구동 30분** | **CAN 오류 0건** (MSI+LSE 검증) |

### 7.2 Fail-safe 테스트

| # | 시나리오 | 조작 | 기대 결과 |
| --- | --- | --- | --- |
| **F1** | 장애물 긴급제동 | 전진 중 벽 접근 | 15cm 앞 정지, 1602 I2C LCD `E-BRAKE` |
| **F2** | 히스테리시스 | 정지 상태에서 벽 근처 유지 | 채터링 없음, 후진은 동작 |
| **F3** | 통신 두절 | 주행 중 CAN 케이블 분리 | 150ms 내 정지, `LINK LOST` |
| **F4** | 송신측 정지 | 조종기 전원 차단 | 차량 자동 정지 |
| **F5** | 데이터 오염 | CRC를 일부러 틀린 프레임 주입 | 프레임 폐기, `err_count` 증가, 
정상 프레임은 계속 처리 |
| **F6** | 태스크 행 | 디버거로 `MotorTask` 정지 | IWDG 리셋 → SAFE_STOP 진입 |
| **F7** | Bus-Off | CANH를 GND에 단락 | Bus-Off 감지 → 정지 → 복구 시 재연결 |

## 8. 리스크 관리

| 리스크 | 확률 | 영향 | 대응 |
| --- | --- | --- | --- |
| L432KC 클럭 정확도 부족으로 CAN 실패 | 중 | 🔴 치명 | ① MCO로 실측 검증 
② SJW=3 폴백 
③ 최후엔 SB17 납땜 HSE 전환 |
| CAN 통신 실패 (M2 지연) | 중 | 🔴 치명 | 3주차에 안 되면 즉시 Loopback으로 회귀해 클럭/타이밍부터 재검증 |
| **L432KC 핀 부족** | 하 | 🟡 중 | §4.1 표대로 고정. 
확장 시 I2C GPIO 익스팬더(PCF8574) 고려 |
| 모터 노이즈로 MCU 리셋 | 상 | 🟠 큼 | 커패시터 선제 장착, 
로직/파워 전원 분리, 배선 꼬기 |
| 브레드보드 접촉 불량 | 상 | 🟠 큼 | 차량 측 만능기판 납땜. 
데모 전날 전체 도통 점검 |
| HC-SR04 오측정 | 중 | 🟡 중 | 3회 측정 중앙값, 
무응답 시 이전값 유지 후 3연속 실패 시 FAULT |
| 일정 지연 | 중 | 🟡 중 | §6.1 버퍼 전략대로 M4/M7 축소, M5·M6 사수 |
