kmwook03/CAN-Failsafe-Node/Hardware/export/RC-CAR.pdf

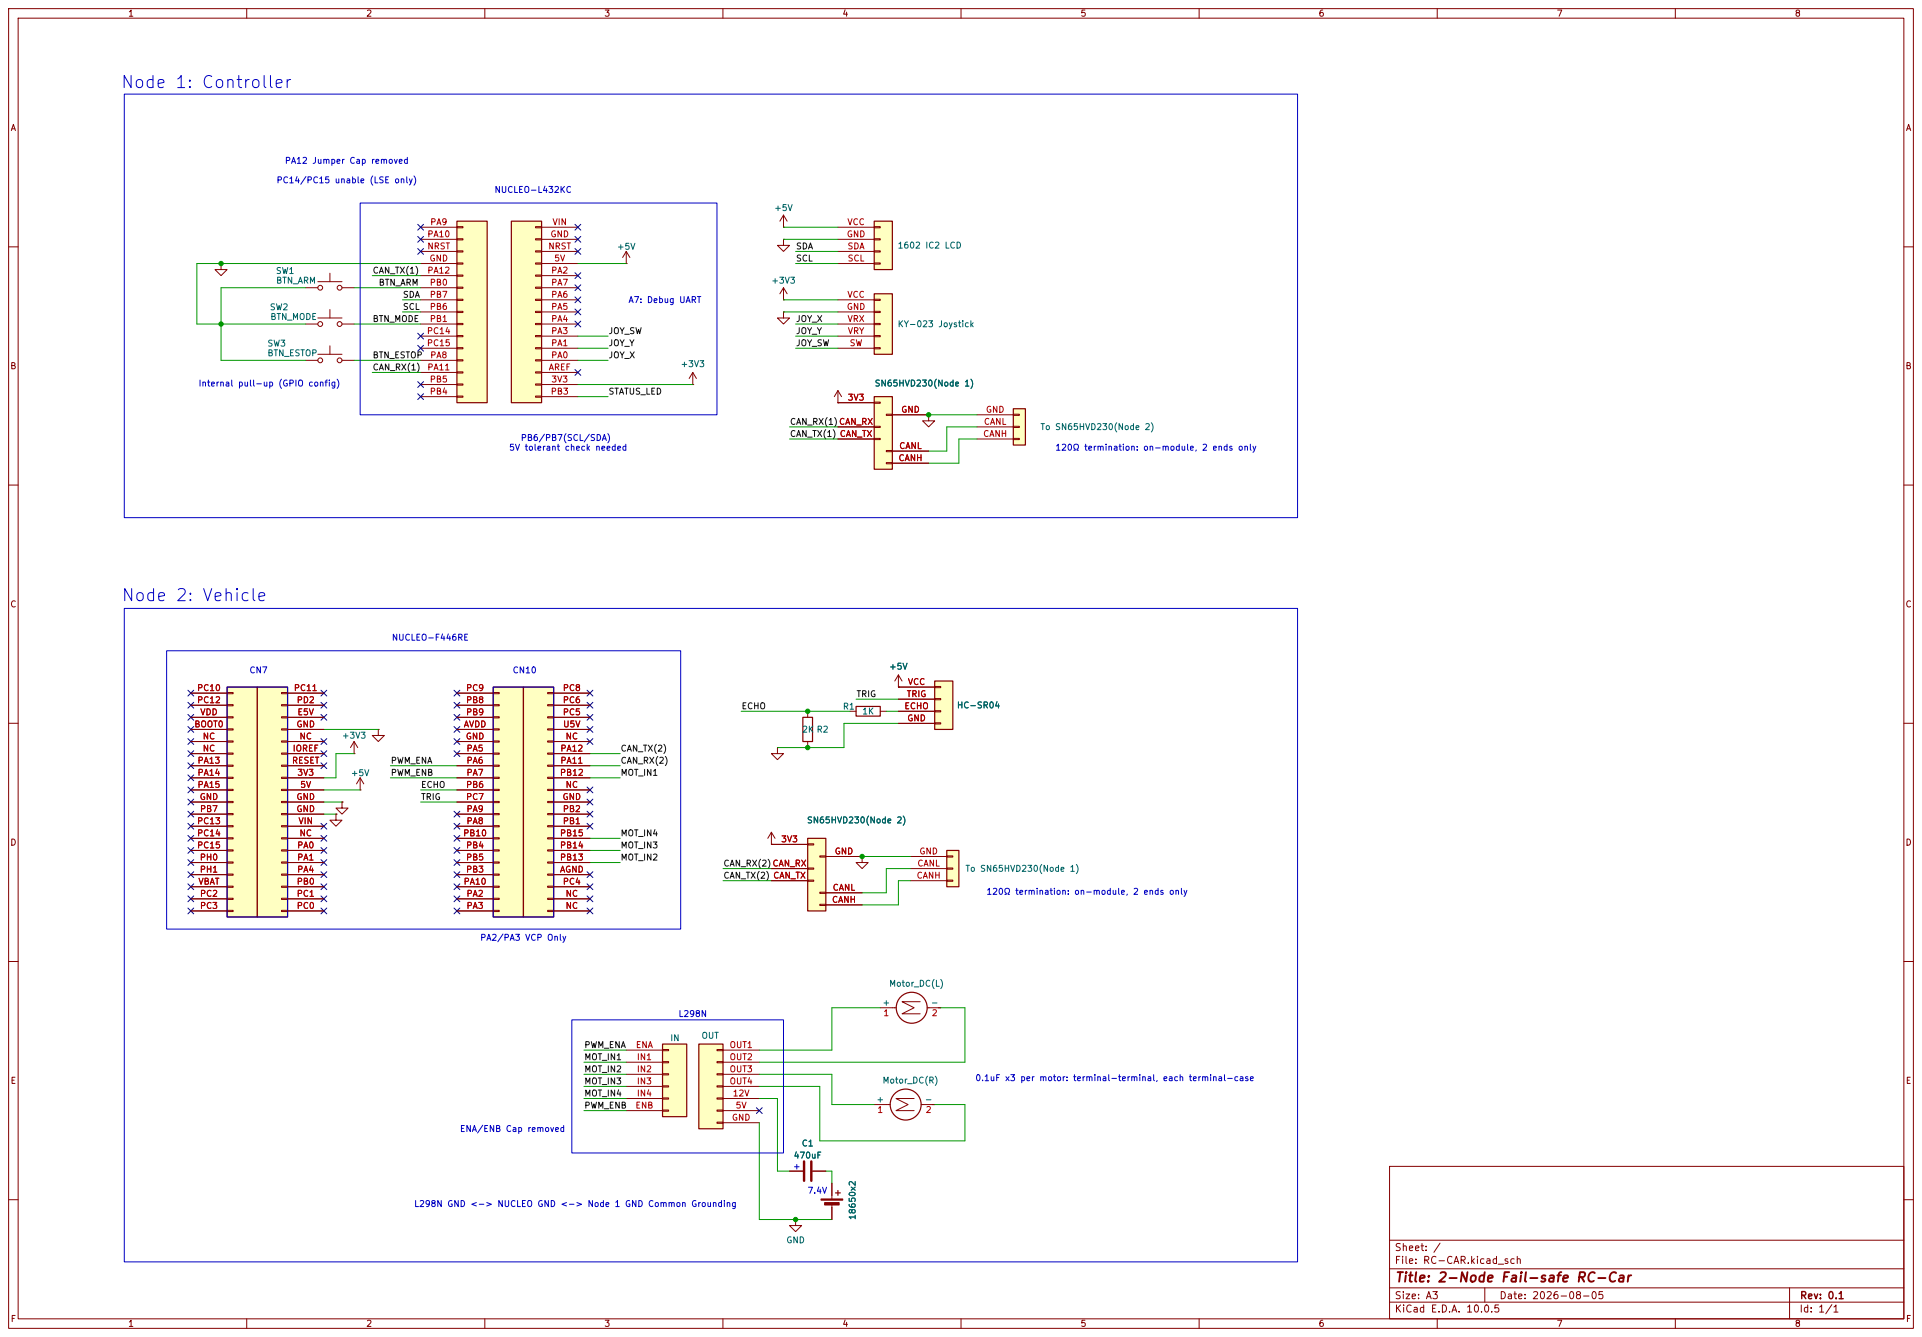
[picture p3: page 1]

120Ω termination: on-module, 2 ends only PA12 Jumper Cap removed PC14/PC15 unable (LSE only)

Internal pull-up (GPIO config)

PB6/PB7(SCL/SDA) 5V tolerant check needed

ENA/ENB Cap removed Node 2: Vehicle
5V E5V GND
IOREF NCNC

0.1uF x3 per motor: terminal-terminal, each terminal-case +

L298N GND <-> NUCLEO GND <-> Node 1 GND Common Grounding

Sheet: /
File: RC-CAR.kicad_sch
Title: 2-Node Fail-safe RC-Car

Size: A3 | Rev: 0.1 | F Date: 2026-08-05
KiCad E.D.A. 10.0.5 | Id: 1/1
