kmwook03/CAN-Failsafe-Node/Hardware/RC-CAR.kicad_sch

## KiCad design Hardware/RC-CAR.kicad_sch (2026-11-07)

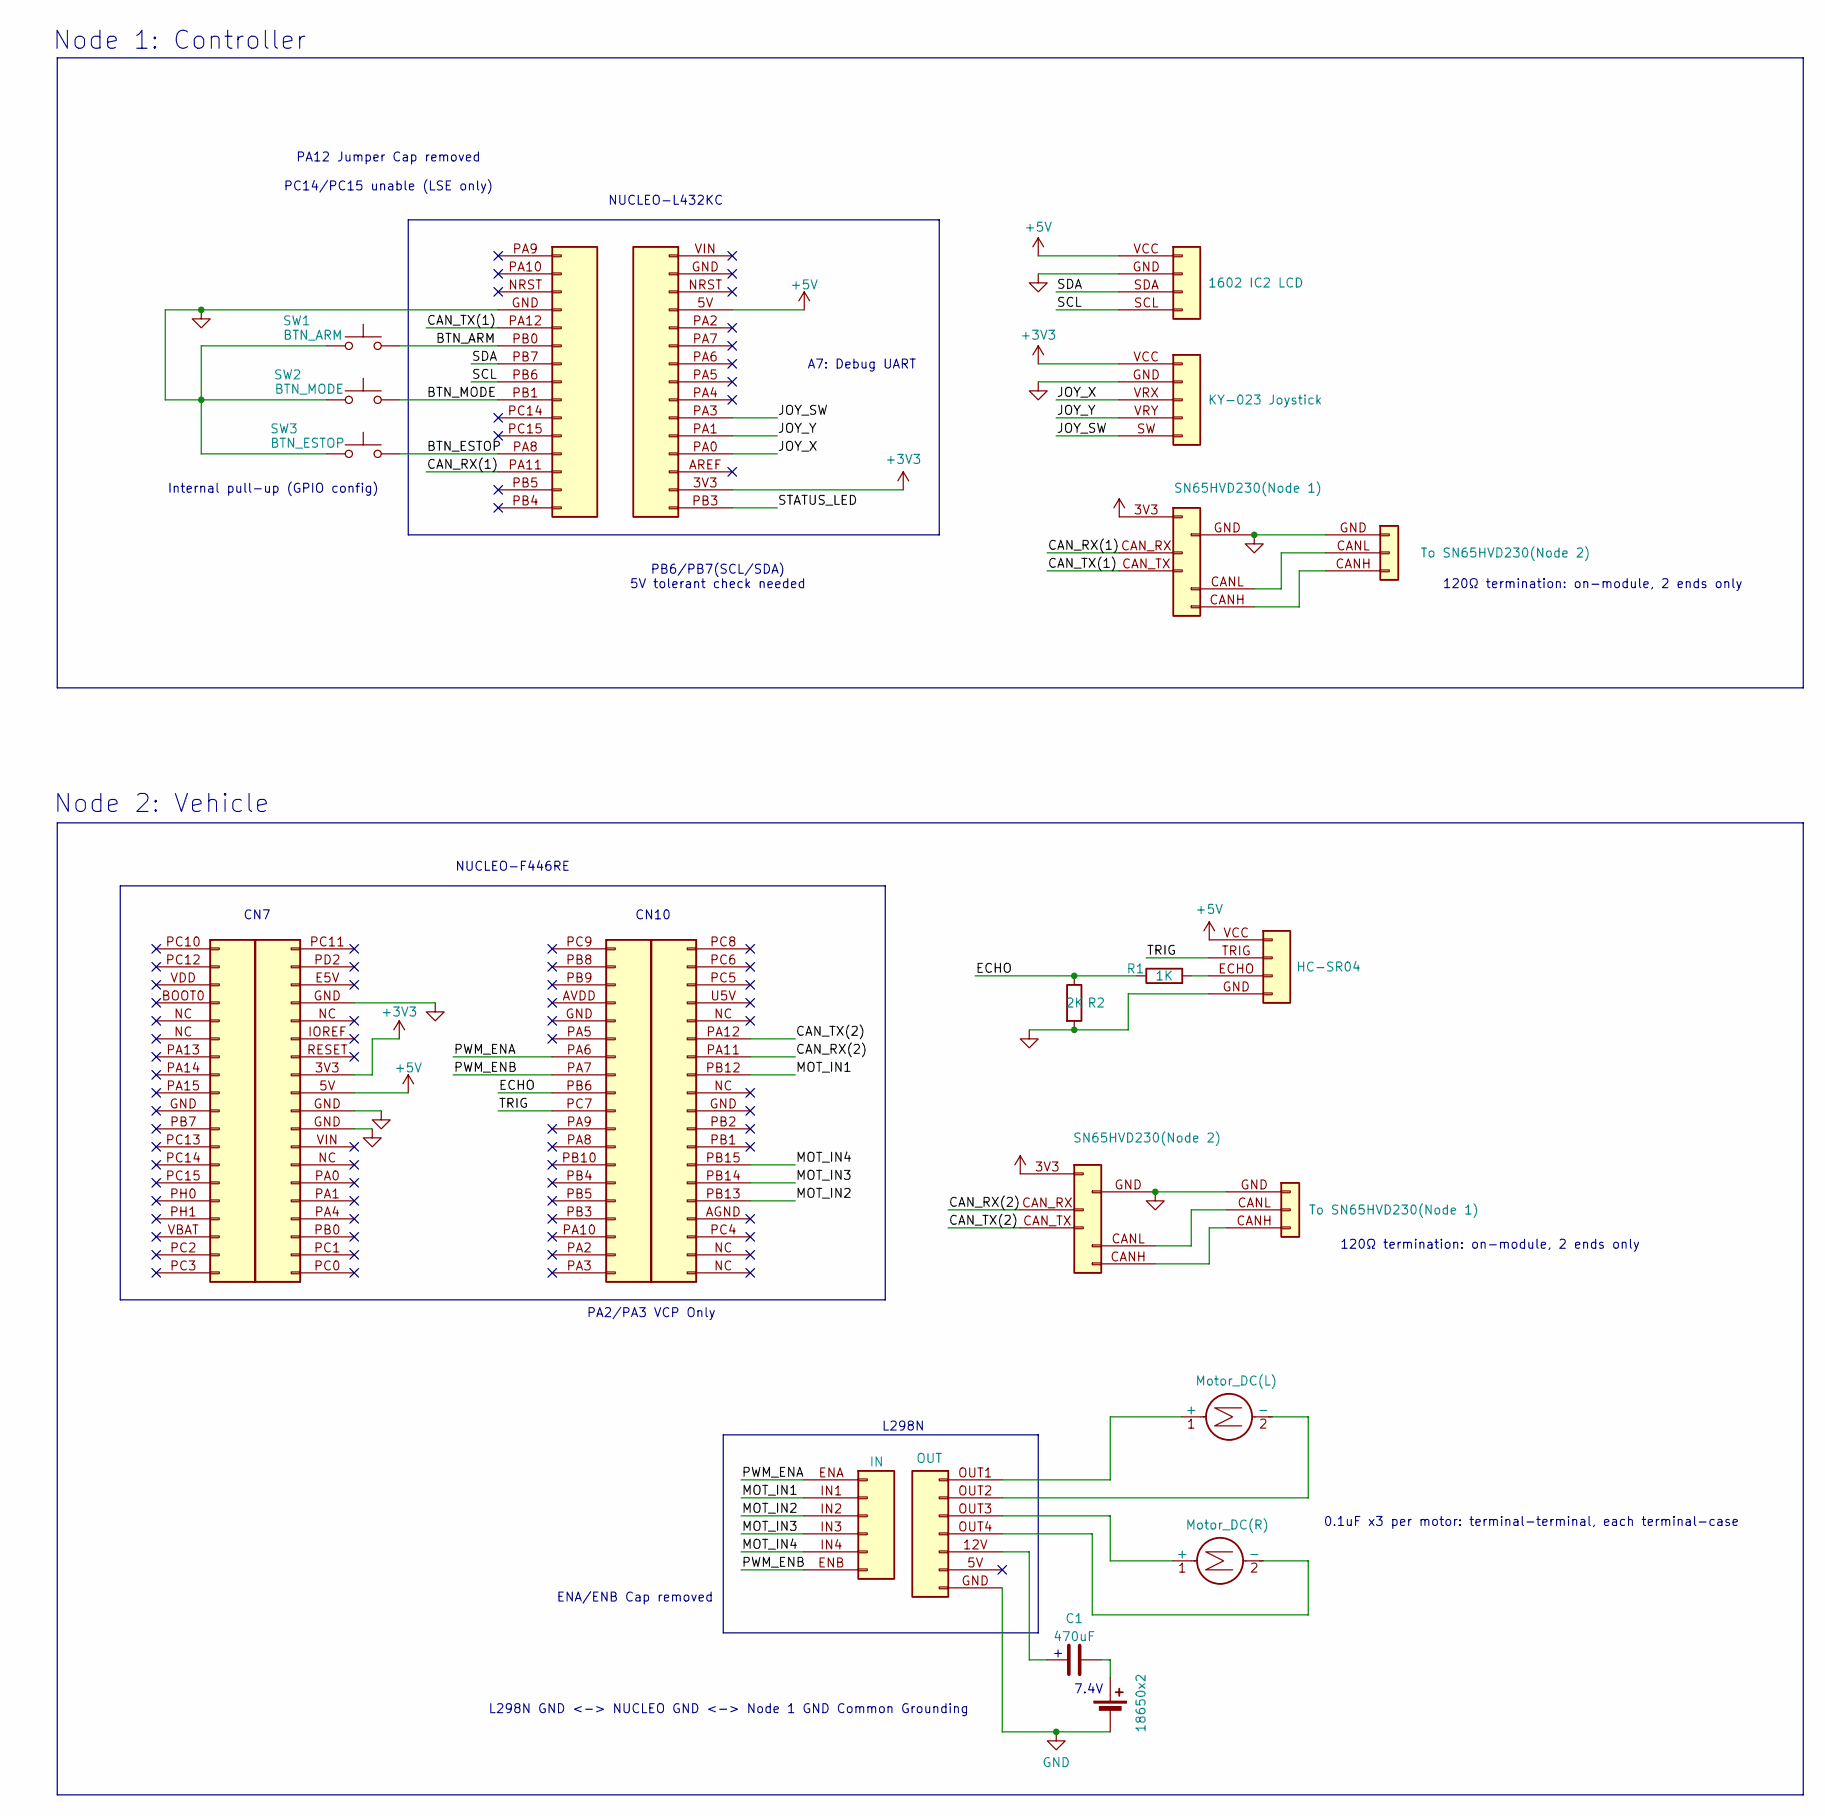
[picture p4: schematic RC-CAR.kicad_sch]

Parts:
BT1: 18650x2
C1: 470uF
J1, J2: NUCLEO-L432KC
J3: To SN65HVD230(Node 2)
J4: 1602 IC2 LCD
J5: KY-023 Joystick
J6, J9: R
J7, J8: L
J10: To SN65HVD230(Node 1)
J11: HC-SR04
J12: IN
J13: OUT
J14: SN65HVD230(Node 2)
J15: SN65HVD230(Node 1)
M1: Motor_DC(L)
M2: Motor_DC(R)
R1: 1K
R2: 2K
SW1: BTN_ARM
SW2: BTN_MODE
SW3: BTN_ESTOP

Connections:
+3V3: J2.3V3 (Pin_14), J5.VCC (Pin_1), J9.3V3 (Pin_8), J14.3V3 (Pin_1), J15.3V3 (Pin_1)
+5V: J2.5V (Pin_4), J4.VCC (Pin_1), J9.5V (Pin_9), J11.VCC (Pin_1)
BTN_ARM: J1.PB0 (Pin_6), SW1.2
BTN_ESTOP: J1.PA8 (Pin_12), SW3.2
BTN_MODE: J1.PB1 (Pin_9), SW2.2
CAN_RX(1): J1.PA11 (Pin_13), J15.CAN_RX (Pin_3)
CAN_RX(2): J6.PA11 (Pin_7), J14.CAN_RX (Pin_3)
CAN_TX(1): J1.PA12 (Pin_5), J15.CAN_TX (Pin_4)
CAN_TX(2): J6.PA12 (Pin_6), J14.CAN_TX (Pin_4)
ECHO: J7.PB6 (Pin_9), R1.1, R2.1
GND: BT1.2 (-), J1.GND (Pin_4), J3.GND (Pin_1), J4.GND (Pin_2), J5.GND (Pin_2), J9.GND (Pin_4), J10.GND (Pin_1), J11.GND (Pin_4), J13.GND (Pin_7), J14.GND (Pin_2), J15.GND (Pin_2), R2.2, SW1.1, SW2.1, SW3.1
JOY_SW: J2.PA3 (Pin_10), J5.SW (Pin_5)
JOY_X: J2.PA0 (Pin_12), J5.VRX (Pin_3)
JOY_Y: J2.PA1 (Pin_11), J5.VRY (Pin_4)
MOT_IN1: J6.PB12 (Pin_8), J12.IN1 (Pin_2)
MOT_IN2: J6.PB13 (Pin_15), J12.IN2 (Pin_3)
MOT_IN3: J6.PB14 (Pin_14), J12.IN3 (Pin_4)
MOT_IN4: J6.PB15 (Pin_13), J12.IN4 (Pin_5)
unnamed: BT1.1 (+), C1.2
unnamed: C1.1, J13.12V (Pin_1)
unnamed: J10.CANH (Pin_3), J14.CANH (Pin_6)
unnamed: J10.CANL (Pin_2), J14.CANL (Pin_5)
unnamed: J11.ECHO (Pin_3), R1.2
unnamed: J13.OUT1 (Pin_3), M1.1 (+)
unnamed: J13.OUT2 (Pin_4), M1.2 (-)
unnamed: J13.OUT3 (Pin_5), M2.1 (+)
unnamed: J13.OUT4 (Pin_6), M2.2 (-)
unnamed: J3.CANH (Pin_3), J15.CANH (Pin_6)
unnamed: J3.CANL (Pin_2), J15.CANL (Pin_5)
PWM_ENA: J7.PA6 (Pin_7), J12.ENA (Pin_1)
PWM_ENB: J7.PA7 (Pin_8), J12.ENB (Pin_6)
SCL: J1.PB6 (Pin_8), J4.SCL (Pin_4)
SDA: J1.PB7 (Pin_7), J4.SDA (Pin_3)
STATUS_LED: J2.PB3 (Pin_15)
TRIG: J7.PC7 (Pin_10), J11.TRIG (Pin_2)

Notes on the sheet:
NUCLEO-L432KC
PA12 Jumper Cap removed PC14/PC15 unable (LSE only)
7.4V
Internal pull-up (GPIO config)
L298N GND <-> NUCLEO GND <-> Node 1 GND Common Grounding
L298N
NUCLEO-F446RE
Node 2: Vehicle
Node 1: Controller
PA2/PA3 VCP Only
PB6/PB7(SCL/SDA) 5V tolerant check needed
CN10
120Ω termination: on-module, 2 ends only
A7: Debug UART
CN7
ENA/ENB Cap removed
0.1uF x3 per motor: terminal-terminal, each terminal-case
