kmwook03/CAN-Failsafe-Node/Firmware/Node1_Controller_L432KC/Core/Src/main.c

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
/* Includes ------------------------------------------------------------------*/
#include "main.h"
#include "cmsis_os.h"

/* USER CODE BEGIN Includes */
#include <stdio.h>
#include "m3_can_test.h"
#include "m3_rtos_test.h"

void M1_LCD_Test_Run(I2C_HandleTypeDef *hi2c, UART_HandleTypeDef *huart);
/* USER CODE END Includes */

/* USER CODE BEGIN PD */
#define M1_TEST_ENABLED 0 /* Archived M1 helpers; not part of M3 CAN test. */
/* USER CODE END PD */

ADC_HandleTypeDef hadc1;
DMA_HandleTypeDef hdma_adc1;

CAN_HandleTypeDef hcan1;

I2C_HandleTypeDef hi2c1;

UART_HandleTypeDef huart2;

/* Definitions for ledTask */
osThreadId_t ledTaskHandle;
const osThreadAttr_t ledTask_attributes = {
  .name = "ledTask",
  .stack_size = 256 * 4,
  .priority = (osPriority_t) osPriorityNormal,
};
/* Definitions for monitorTask */
osThreadId_t monitorTaskHandle;
const osThreadAttr_t monitorTask_attributes = {
  .name = "monitorTask",
  .stack_size = 512 * 4,
  .priority = (osPriority_t) osPriorityLow,
};
/* Definitions for canTxTask */
osThreadId_t canTxTaskHandle;
const osThreadAttr_t canTxTask_attributes = {
  .name = "canTxTask",
  .stack_size = 256 * 4,
  .priority = (osPriority_t) osPriorityAboveNormal1,
};
/* Definitions for canRxTask */
osThreadId_t canRxTaskHandle;
const osThreadAttr_t canRxTask_attributes = {
  .name = "canRxTask",
  .stack_size = 256 * 4,
  .priority = (osPriority_t) osPriorityAboveNormal,
};
/* USER CODE BEGIN PV */
#if M1_TEST_ENABLED
#define ADC_CH_CNT   2
#define MA_LEN       8
#define BTN_DEBOUNCE_MS 25u

typedef enum { BTN_ARM = 0, BTN_MODE, BTN_ESTOP, BTN_COUNT } btn_id_t;

static volatile uint32_t s_btn_last[BTN_COUNT] = {0};
static volatile uint8_t s_btn_event[BTN_COUNT] = {0};
static volatile uint32_t s_irq_raw[BTN_COUNT] = {0}; /* For check: ISR entry count */
static volatile uint8_t s_btn_down[BTN_COUNT] = {0};

static const uint16_t BTN_PIN[BTN_COUNT] = {
		BTN_ARM_Pin, BTN_MODE_Pin, BTN_ESTOP_Pin
};
static GPIO_TypeDef * const BTN_PORT[BTN_COUNT] = {
		BTN_ARM_GPIO_Port, BTN_MODE_GPIO_Port, BTN_ESTOP_GPIO_Port
};

static volatile uint16_t g_adc_raw[ADC_CH_CNT];
#endif
/* USER CODE END PV */

void SystemClock_Config(void);
static void MX_GPIO_Init(void);
static void MX_DMA_Init(void);
static void MX_ADC1_Init(void);
static void MX_USART2_UART_Init(void);
static void MX_I2C1_Init(void);
static void MX_CAN1_Init(void);
void StartLedTask(void *argument);
void StartMonitorTask(void *argument);
void StartCanTxTask(void *argument);
void StartCanRxTask(void *argument);

/* USER CODE BEGIN PFP */
#if M1_TEST_ENABLED
static uint8_t btn_take(btn_id_t id);
static void btn_release_scan(void);
#endif
/* USER CODE END PFP */

/**
  * @brief  The application entry point.
  * @retval int
  */
int main(void)
{

  /* MCU Configuration--------------------------------------------------------*/

  /* Reset of all peripherals, Initializes the Flash interface and the Systick. */
  HAL_Init();

  /* Configure the system clock */
  SystemClock_Config();

  /* USER CODE BEGIN SysInit */
  if (M3_CAN_Test_PrepareClock() != HAL_OK) {
    M3_RtosFatal(M3_FAULT_HAL);
  }
  /* USER CODE END SysInit */

  /* Initialize all configured peripherals */
  MX_GPIO_Init();
  MX_DMA_Init();
  MX_ADC1_Init();
  MX_USART2_UART_Init();
  MX_I2C1_Init();
  MX_CAN1_Init();
  /* USER CODE BEGIN 2 */
  /* CAN starts in canTxTask after the scheduler is running. */
  /* USER CODE END 2 */

  /* Init scheduler */
  osKernelInitialize();

  /* USER CODE BEGIN RTOS_MUTEX */
  /* add mutexes, ... */
  /* USER CODE END RTOS_MUTEX */

  /* USER CODE BEGIN RTOS_SEMAPHORES */
  /* add semaphores, ... */
  /* USER CODE END RTOS_SEMAPHORES */

  /* USER CODE BEGIN RTOS_TIMERS */
  /* start timers, add new ones, ... */
  /* USER CODE END RTOS_TIMERS */

  /* USER CODE BEGIN RTOS_QUEUES */
  M3_CAN_Test_Init(&hcan1);
  /* USER CODE END RTOS_QUEUES */

  /* Create the thread(s) */
  /* creation of ledTask */
  ledTaskHandle = osThreadNew(StartLedTask, NULL, &ledTask_attributes);

  /* creation of monitorTask */
  monitorTaskHandle = osThreadNew(StartMonitorTask, NULL, &monitorTask_attributes);

  /* creation of canTxTask */
  canTxTaskHandle = osThreadNew(StartCanTxTask, NULL, &canTxTask_attributes);

  /* creation of canRxTask */
  canRxTaskHandle = osThreadNew(StartCanRxTask, NULL, &canRxTask_attributes);

  /* USER CODE BEGIN RTOS_THREADS */
  if ((ledTaskHandle == NULL) || (monitorTaskHandle == NULL) ||
      (canTxTaskHandle == NULL) || (canRxTaskHandle == NULL)) {
    M3_RtosFatal(M3_FAULT_ALLOCATION);
  }
  /* USER CODE END RTOS_THREADS */

  /* USER CODE BEGIN RTOS_EVENTS */
  /* add events, ... */
  /* USER CODE END RTOS_EVENTS */

  /* Initialize leds */
  BSP_LED_Init(LED_GREEN);

  /* Start scheduler */
  osKernelStart();

  /* We should never get here as control is now taken by the scheduler */

  /* Infinite loop */
  /* USER CODE BEGIN WHILE */
  M3_RtosFatal(M3_FAULT_KERNEL);
  while (1) {
    /* USER CODE END WHILE */

    /* USER CODE BEGIN 3 */
  }
  /* USER CODE END 3 */
}

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
/* USER CODE BEGIN 4 */
int __io_putchar(int ch)
{
  HAL_UART_Transmit(&huart2, (uint8_t *)&ch, 1, HAL_MAX_DELAY);
  return ch;
}

#if M1_TEST_ENABLED
void HAL_GPIO_EXTI_Callback(uint16_t GPIO_Pin)
{
  btn_id_t id;

  switch (GPIO_Pin) {
    case BTN_ARM_Pin: id = BTN_ARM; break;
    case BTN_MODE_Pin: id = BTN_MODE; break;
    case BTN_ESTOP_Pin: id = BTN_ESTOP; break;
    default: return;
  }

  s_irq_raw[id]++;

  if (s_btn_down[id]) return;
  /* time filter: unsigned subtraction -> safe from tick overflow */
  uint32_t now = HAL_GetTick();
  if ((uint32_t)(now - s_btn_last[id]) < BTN_DEBOUNCE_MS) return;

  s_btn_last[id] = now;
  s_btn_down[id] = 1;
  s_btn_event[id] = 1;
}

static uint8_t btn_take(btn_id_t id)
{
  uint8_t ev;
  __disable_irq();
  ev = s_btn_event[id];
  s_btn_event[id] = 0;
  __enable_irq();
  return ev;
}

static void btn_release_scan(void)
{
  uint32_t now = HAL_GetTick();

  for (int i = 0; i < BTN_COUNT; i++) {
	  if (!s_btn_down[i]) continue;

	  if (HAL_GPIO_ReadPin(BTN_PORT[i], BTN_PIN[i]) == GPIO_PIN_SET) {
		  if ((uint32_t)(now - s_btn_last[i]) >= BTN_DEBOUNCE_MS) {
			  s_btn_down[i] = 0;
		  }
	  } else {
		  s_btn_last[i] = now;
	  }
  }
}
#endif /* M1_TEST_ENABLED */
/* USER CODE END 4 */

/* USER CODE BEGIN Header_StartLedTask */
/**
  * @brief  Function implementing the ledTask thread.
  * @param  argument: Not used
  * @retval None
  */
/* USER CODE END Header_StartLedTask */
void StartLedTask(void *argument)
{
  /* USER CODE BEGIN 5 */
  M3_LedTask(argument);
  /* USER CODE END 5 */
}

/* USER CODE BEGIN Header_StartMonitorTask */
/**
* @brief Function implementing the monitorTask thread.
* @param argument: Not used
* @retval None
*/
/* USER CODE END Header_StartMonitorTask */
void StartMonitorTask(void *argument)
{
  /* USER CODE BEGIN StartMonitorTask */
  M3_MonitorTask(argument);
  /* USER CODE END StartMonitorTask */
}

/* USER CODE BEGIN Header_StartCanTxTask */
/**
* @brief Function implementing the canTxTask thread.
* @param argument: Not used
* @retval None
*/
/* USER CODE END Header_StartCanTxTask */
void StartCanTxTask(void *argument)
{
  /* USER CODE BEGIN StartCanTxTask */
  M3_CAN_Test_TxTask(argument);
  /* USER CODE END StartCanTxTask */
}

/* USER CODE BEGIN Header_StartCanRxTask */
/**
* @brief Function implementing the canRxTask thread.
* @param argument: Not used
* @retval None
*/
/* USER CODE END Header_StartCanRxTask */
void StartCanRxTask(void *argument)
{
  /* USER CODE BEGIN StartCanRxTask */
  M3_CAN_Test_RxTask(argument);
  /* USER CODE END StartCanRxTask */
}

/**
  * @brief  Period elapsed callback in non blocking mode
  * @note   This function is called  when TIM6 interrupt took place, inside
  * HAL_TIM_IRQHandler(). It makes a direct call to HAL_IncTick() to increment
  * a global variable "uwTick" used as application time base.
  * @param  htim : TIM handle
  * @retval None
  */
void HAL_TIM_PeriodElapsedCallback(TIM_HandleTypeDef *htim)
{
  if (htim->Instance == TIM6)
  {
    HAL_IncTick();
  }
}

/**
  * @brief  This function is executed in case of error occurrence.
  * @retval None
  */
void Error_Handler(void)
{
  /* USER CODE BEGIN Error_Handler_Debug */
  M3_RtosFatal(M3_FAULT_HAL);
  /* USER CODE END Error_Handler_Debug */
}
#ifdef USE_FULL_ASSERT
/**
  * @brief  Reports the name of the source file and the source line number
  *         where the assert_param error has occurred.
  * @param  file: pointer to the source file name
  * @param  line: assert_param error line source number
  * @retval None
  */
void assert_failed(uint8_t *file, uint32_t line)
{
  /* USER CODE BEGIN 6 */
  /* User can add his own implementation to report the file name and line number,
     ex: printf("Wrong parameters value: file %s on line %d\r\n", file, line) */
  /* USER CODE END 6 */
}
#endif /* USE_FULL_ASSERT */
