kmwook03/CAN-Failsafe-Node/Firmware/Node1_Controller_L432KC/Node1_Controller_L432KC.ioc

Mcu.UserName=STM32L432KCUx
PA0.Signal=ADCx_IN5
PA1.Signal=ADCx_IN6
PA11.Signal=CAN1_RX
PA12.Signal=CAN1_TX
PA2.GPIO_Label=VCP_TX
PA2.Signal=USART2_TX
PA8.GPIO_Label=BTN_ESTOP
PA8.Signal=GPXTI8
PB0.GPIO_Label=BTN_ARM
PB0.Signal=GPXTI0
PB1.GPIO_Label=BTN_MODE
PB1.Signal=GPXTI1
PB6.Signal=I2C1_SCL
PB7.Signal=I2C1_SDA
