kmwook03/CAN-Failsafe-Node/(commit log)

2026-08-08 docs: blueprint
    [RC-CAR.kicad_sch]
2026-08-11 feat: M1 Node1 DoD 통과
2026-11-07 feat: M2 Node2 DoD half
    [RC-CAR.kicad_sch]
2026-11-09 feat: M2 Node2 DoD 통과
