kmwook03/CAN-Failsafe-Node/(notices)

Notices in the files:
Firmware/Node2_Vehicle_F446RE/Core/Inc/main.h:
Copyright (c) 2026 STMicroelectronics.
All rights reserved.
This software is licensed under terms that can be found in the LICENSE file
